tdouez/c34w/README.md

# c34w

Module wifi pour le TEMPO Linky avec une sortie relais programmable suiva la couleur de la journée.
Indication par leds des coumleurs du jour et du lendemain.

https://fumeebleue.fr/module_tempo/c34w/
