tdouez/c34w/kicad/c34/c34.kicad_pcb

## KiCad design kicad/c34/c34.kicad_pcb (2024-09-27)

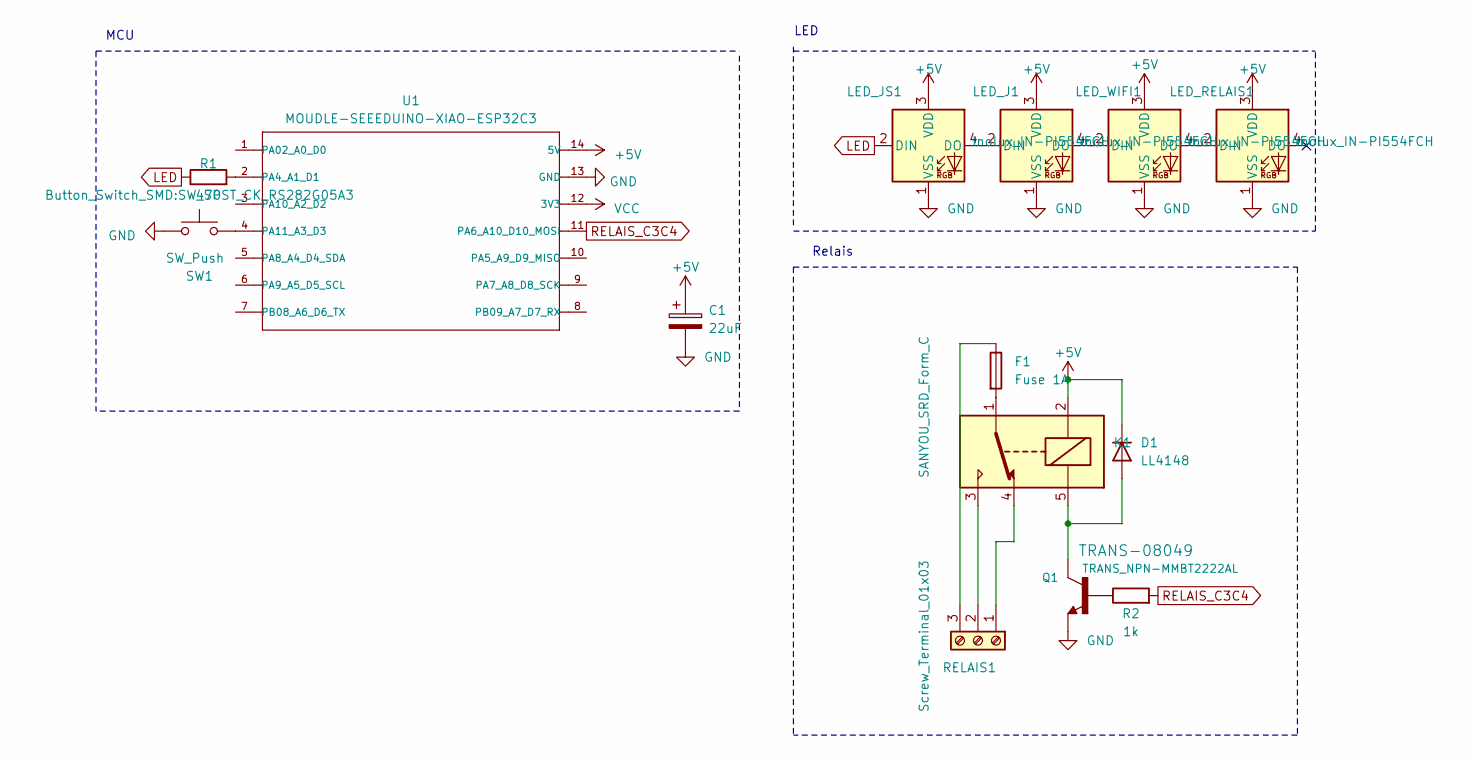
[picture p1: schematic c34.kicad_sch]

Parts:
C1: 22uF; C_1210_3225Metric_Pad1.33x2.70mm_HandSolder
D1: LL4148; D_MiniMELF
F1: Fuse 1A; 696310001002
K1: SANYOU_SRD_Form_C; Relay_SPDT_SANYOU_SRD_Series_Form_C
LED_J1: Inolux_IN-PI554FCH; LED_Inolux_IN-PI554FCH_PLCC4_5.0x5.0mm_P3.2mm
LED_JS1: Inolux_IN-PI554FCH; LED_Inolux_IN-PI554FCH_PLCC4_5.0x5.0mm_P3.2mm
LED_RELAIS1: Inolux_IN-PI554FCH; LED_Inolux_IN-PI554FCH_PLCC4_5.0x5.0mm_P3.2mm
LED_WIFI1: Inolux_IN-PI554FCH; LED_Inolux_IN-PI554FCH_PLCC4_5.0x5.0mm_P3.2mm
Q1: TRANS_NPN-MMBT2222AL; SOT-23
R1: 470; R_1206_3216Metric_Pad1.30x1.75mm_HandSolder
R2: 1k; R_1206_3216Metric_Pad1.30x1.75mm_HandSolder
RELAIS1: Screw_Terminal_01x03; TerminalBlock_Altech_AK300-3_P5.00mm
SW1: SW_Push; SW_SPST_CK_RS282G05A3
U1: MOUDLE-SEEEDUINO-XIAO-ESP32C3; MOUDLE14P-SMD-2.54-21X17.8MM

Connections:
+5V: C1.1, D1.1 (K), K1.2, LED_J1.3 (VDD), LED_JS1.3 (VDD), LED_RELAIS1.3 (VDD), LED_WIFI1.3 (VDD), U1.14 (5V)
GND: C1.2, LED_J1.1 (VSS), LED_JS1.1 (VSS), LED_RELAIS1.1 (VSS), LED_WIFI1.1 (VSS), Q1.2 (E), SW1.1, U1.13 (GND)
LED: LED_JS1.2 (DIN), R1.1
unnamed: D1.2 (A), K1.5, Q1.3 (C)
unnamed: F1.2, K1.1
unnamed: LED_J1.2 (DIN), LED_JS1.4 (DO)
unnamed: LED_J1.4 (DO), LED_WIFI1.2 (DIN)
unnamed: LED_RELAIS1.2 (DIN), LED_WIFI1.4 (DO)
unnamed: Q1.1 (B), R2.1
unnamed: K1.4, RELAIS1.1
unnamed: K1.3, RELAIS1.2
unnamed: F1.1, RELAIS1.3
unnamed: R1.2, U1.2 (PA4_A1_D1)
unnamed: SW1.2, U1.4 (PA11_A3_D3)
RELAIS_C3C4: R2.2, U1.11 (PA6_A10_D10_MOSI)
VCC: U1.12 (3V3)

Notes on the sheet:
MCU
Relais
LED

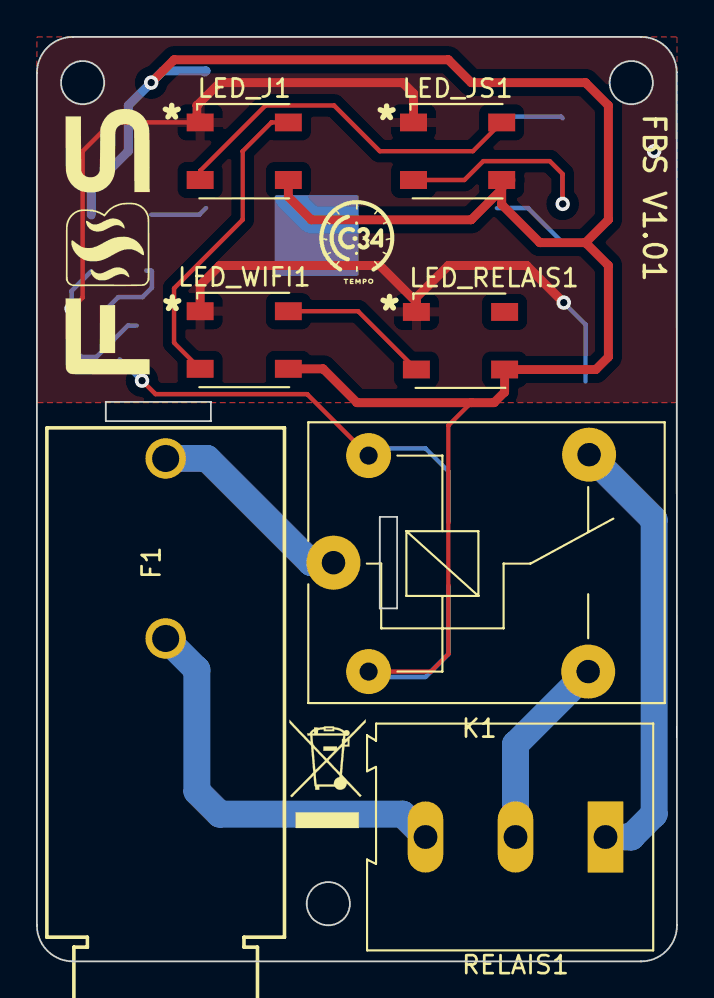
[picture p2: board c34.kicad_pcb from above]

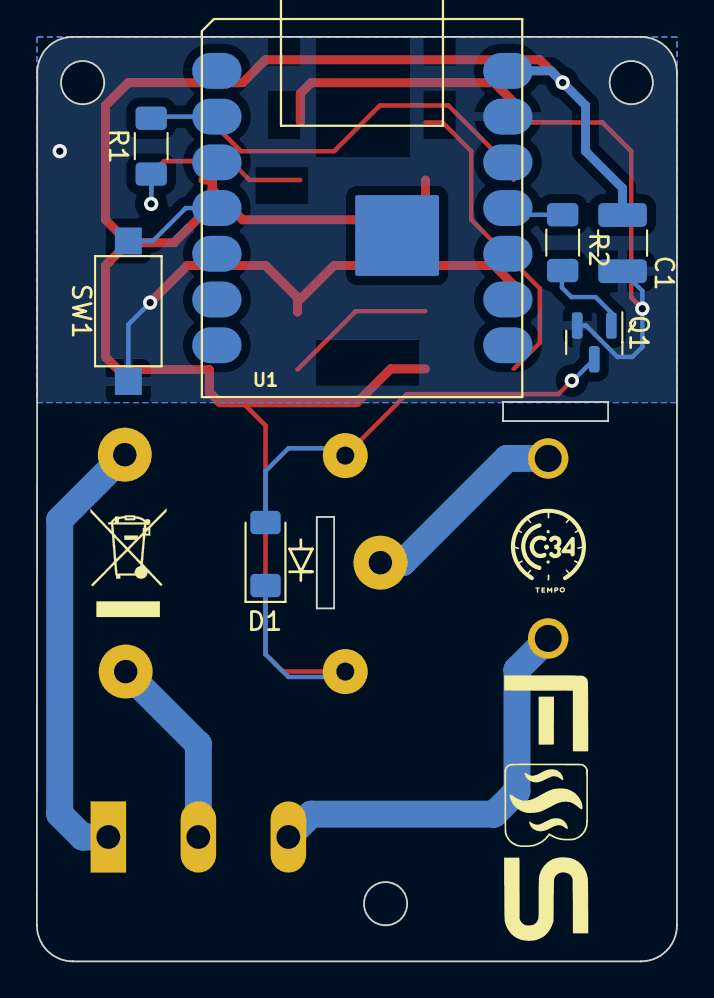
[picture p3: board c34.kicad_pcb from below]

Board: 2 copper layers, 35.6 x 51.4 mm, 14 parts (7 on the bottom side), 15 nets.
