tdouez/c34w/C34w_web.h

//--------------------------------------------------------------------------------------------------
const char fbs_jpg[] PROGMEM = 
"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";

//--------------------------------------------------------------------------------------------------
const char favicon_ico[] PROGMEM = 
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
"AH8AAAA/AAD/gAAAAI8AAAC/AAD//wAA";

//--------------------------------------------------------------------------------------------------
const char index_html[] PROGMEM = R"rawliteral(
<!DOCTYPE html>
<html lang="fr">

<head>
    <title>C34w TEMPO</title>
    <meta name="viewport" content="width=device-width, initial-scale=1"charset="UTF-8" />
    <link rel="stylesheet" type="text/css" href="https://www.w3schools.com/w3css/4/w3.css">
    <script type="text/javascript" src="https://cdnjs.cloudflare.com/ajax/libs/jquery/3.6.0/jquery.min.js"></script>
    <script type="text/javascript" src="script.js"></script>
    <script type="https://cdnjs.cloudflare.com/ajax/libs/notify/0.4.2/notify.min.js"></script>
</head>

<body class="w3-animate-opacity">

    <!-- Entete et menu -->
    <div class="w3-card w3-blue w3-padding-small w3-center">
         <h1>C34w TEMPO</h1><span id="version">v0.00</span>
    </div>

    <!-- Information -->
    <div id="info" class="w3-margin w3-card menu">
        <div class="w3-container w3-text-blue">
            <h1>Information</h1>
        </div>
		    <div class="w3-padding">Nom Module: <b id="module_name"></b></div>
        <hr>
        <div class="w3-padding">Date: <b id="currentDate">01/01/1970</b></div>
        <div class="w3-padding">Couleur du jour: <b id="couleur_jour">indéfinie</b></div>
        <div class="w3-padding">Couleur demain: <b id="couleur_demain">indéfinie</b></div>
        <div class="w3-padding">Heure: <b id="heure">indéfinie</b></div>
		<div class="w3-padding">Relais: <b id="etat_relais">off</b></div>
	</div>
	<div id="config" class="w3-margin w3-card menu">
		<form id="form_config" class="w3-container w3-padding">
			<div class="w3-container w3-text-blue">
				<h1>Configuration relais</h1>
			</div>
			<div class="w3-padding">
				<fieldset><legend><b style="color:blue;">Jour Bleu</b></legend>
					<div><input type='checkbox' name='b_hc_name' id='b_hc_name'/><label> Heure creuse</label></div>
					<div><input type='checkbox' name='b_hp_name' id='b_hp_name'/><label> Heure pleine</label></div>
				</fieldset>
				<fieldset><legend><b>Jour Blanc</b></legend>
					<div><input type='checkbox' name='w_hc_name' id='w_hc_name'/><label> Heure creuse</label></div>
					<div><input type='checkbox' name='w_hp_name' id='w_hp_name'/><label> Heure pleine</label></div>
				</fieldset>
				<fieldset><legend><b style="color:red;">Jour Rouge</b></legend>
					<div><input type='checkbox' name='r_hc_name' id='r_hc_name'/><label> Heure creuse</label></div>
					<div><input type='checkbox' name='r_hp_name' id='r_hp_name'/><label> Heure pleine</label></div>
				</fieldset>
			</div>
		</form>
        <button onclick="savButton()" class="w3-btn w3-blue w3-border">Sauvegarde</button>
    </div>
	<div class="w3-panel w3-green" id="p_info" style="display:none"><span id="t_info">aaaaa</span></div>
    <div class="w3-panel w3-red" id="p_erreur_info" style="display:none"><span id="t_erreur_info">eeee</span></div>

    <div class="w3-padding w3-right">
    <img src="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" alt="FBS" width="50"><a href="https://fumeebleue.fr" style="text-decoration: none;"> Fumée Bleue 2024</a></i>
    </div>

</body>

</html>

)rawliteral";

//--------------------------------------------------------------------------------------------------

const char script_js[] PROGMEM = R"rawliteral(
/* sav config */
function savButton() {
    console.log("Sav config");
    console.log($("#form_config").serialize());
    $.post('/config.htm', $("#form_config").serialize())
        .done( function(msg, textStatus, xhr) {
            console.log($("#form_config").serialize());
            $.notify("Enregistrement effectuĂ©", "success");
        })
        .fail( function(xhr, textStatus, errorThrown) {
            $.notify("Enregistrement impossible "+ errorThrown, "error");
        })
        console.log("Form Submit config");
}

/* fonction lecture json */
function lire_item_json_info(myjson) {
    console.log("lire item json info");


    let j = JSON.parse(myjson, function(name, value) {

        if (name == "version") {
            document.getElementById("version").innerHTML = value;
        }
        if (name == "module_name") {
            document.getElementById("module_name").innerHTML = value;
        }
		    if (name == "date") {
            document.getElementById("date").innerHTML = value;
        }
        if (name == "couleur_jour") {
            document.getElementById("couleur_jour").innerHTML = value;
			      document.getElementById("couleur_jour").style.color = 'orange';
			      if (value.indexOf("BLEU") != -1) document.getElementById("couleur_jour").style.color = 'blue';
			      if (value.indexOf("BLANC") != -1) document.getElementById("couleur_jour").style.color = 'black';
			      if (value.indexOf("ROUGE") != -1) document.getElementById("couleur_jour").style.color = 'red';
        }
		    if (name == "couleur_demain") {
            document.getElementById("couleur_demain").innerHTML = value;
			      document.getElementById("couleur_demain").style.color = 'orange';
			      if (value.indexOf("BLEU") != -1) document.getElementById("couleur_demain").style.color = 'blue';
			      if (value.indexOf("BLANC") != -1) document.getElementById("couleur_demain").style.color = 'black';
			      if (value.indexOf("ROUGE") != -1) document.getElementById("couleur_demain").style.color = 'red';
        }
		    if (name == "heure") {
            if (value == "HP") {
				          document.getElementById("heure").style.color = 'red';
				          document.getElementById("heure").innerHTML = value;
			      }
			      if (value == "HC") {
				          document.getElementById("heure").style.color = 'green';
				          document.getElementById("heure").innerHTML = value;
			      }
        }
		    if (name == "etat_relais") {
            document.getElementById("etat_relais").innerHTML = value;
        }
        if (name == "info") {
            affiche_info_info(value);
        }
        if (name == "erreur_info") {
            affiche_erreur_info(value);
        }
        if (name == "current_date") {
            document.getElementById("currentDate").innerHTML = value;
        }

    });
}

/* fonction lecture json */
function lire_item_json_config(myjson) {
    console.log("lire item json cfg");

    document.getElementById("b_hc_name").checked = false;
    document.getElementById("b_hp_name").checked = false;
    document.getElementById("w_hc_name").checked = false;
    document.getElementById("w_hp_name").checked = false;
    document.getElementById("r_hc_name").checked = false;
    document.getElementById("r_hp_name").checked = false;

    let j = JSON.parse(myjson, function(name, value) {

        if (name == "b_hc_name") {
          if (value == 1) document.getElementById("b_hc_name").checked = true;
        }
        if (name == "b_hp_name") {
          if (value == 1) document.getElementById("b_hp_name").checked = true;
        }
        if (name == "w_hc_name") {
          if (value == 1) document.getElementById("w_hc_name").checked = true;
        }
        if (name == "w_hp_name") {
          if (value == 1) document.getElementById("w_hp_name").checked = true;
        }
        if (name == "r_hc_name") {
          if (value == 1) document.getElementById("r_hc_name").checked = true;
        }
        if (name == "r_hp_name") {
          if (value == 1) document.getElementById("r_hp_name").checked = true;
        }

    });
}


/* affiche info sur panel info*/
function affiche_info_info(buffer) {
    document.getElementById("t_info").innerHTML = buffer;
    if (buffer == "") {
        document.getElementById("p_info").style.display = "none";
    }
    else {
        document.getElementById("p_info").style.display = "block";
    }
}

/* affiche erreur sur panel info*/
function affiche_erreur_info(buffer) {
    document.getElementById("t_erreur_info").innerHTML = buffer;
    if (buffer == "") {
        document.getElementById("p_erreur_info").style.display = "none";
    }
    else {
        document.getElementById("p_erreur_info").style.display = "block";
    }
}


/* mise a jour info module */
function maj_infos() {
    console.log("maj infos");

    $.getJSON("/info.json", function(data) {
        let myNewJSON = JSON.stringify(data, null, '\t');
        lire_item_json_info(myNewJSON);
    })
    .fail(function(xhr, textStatus, errorThrown) {
        console.log( "error " + errorThrown );
    });
}

/* init */
function init () {
    console.log("get /config.json");

    $.getJSON("/config.json", function(data) {
        let myNewJSON = JSON.stringify(data, null, '\t');
        lire_item_json_config(myNewJSON);
    })
    .fail(function(xhr, textStatus, errorThrown) {
        console.log( "error " + errorThrown );
    });
    $.getJSON("/info.json", function(data) {
        let myNewJSON = JSON.stringify(data, null, '\t');
        lire_item_json_info(myNewJSON);
    })
    .fail(function(xhr, textStatus, errorThrown) {
        console.log( "error " + errorThrown );
    });
}

window.onload=init();
timer = window.setInterval("maj_infos()", 5000);

)rawliteral";
