tdouez/c34w/(commit log)

2024-02-12 V1.1.0
    Mise à jour TEMPO toutes les 15 minutes au lieu de toutes les heures
2024-02-26 v1.2.0
    Correction sur les heures HP et HC inversées
    Passage mise à jour toules les 5 minutes.
    Ajout clignotement jour en HP
    [C34w.ino]
2024-02-26 v1.2.0
    maj kicad
    [c34.kicad_pcb, c34.kicad_sch]
2024-03-08 v1.2.1
    Ajout test leds au démarrage
2024-03-11 v1.2.1
    Ajout test leds et relais au démarrage
2024-09-05 1.3.0
    Changement de serveur pour la récupération de la couleur TEMPO
2024-09-27 v1.3.1
    Intégration pages web en zone PROGMEM et modif pcb 1.1
    [c34.kicad_pcb]
